francklemoine/Ampli-HiFi/README.md

# HiFi

This repository contains my amplifier and pre-amplifier schematics, program and housing.
