francklemoine/Ampli-HiFi/(list of files, cad)

Other CAD files:
Boitier/ampli.dxf
Boitier/ampli.dwg
