francklemoine/Ampli-HiFi/KiCad/select_board/select_board.kicad_pcb

## KiCad design KiCad/select_board/select_board.kicad_pcb (2017-11-20)

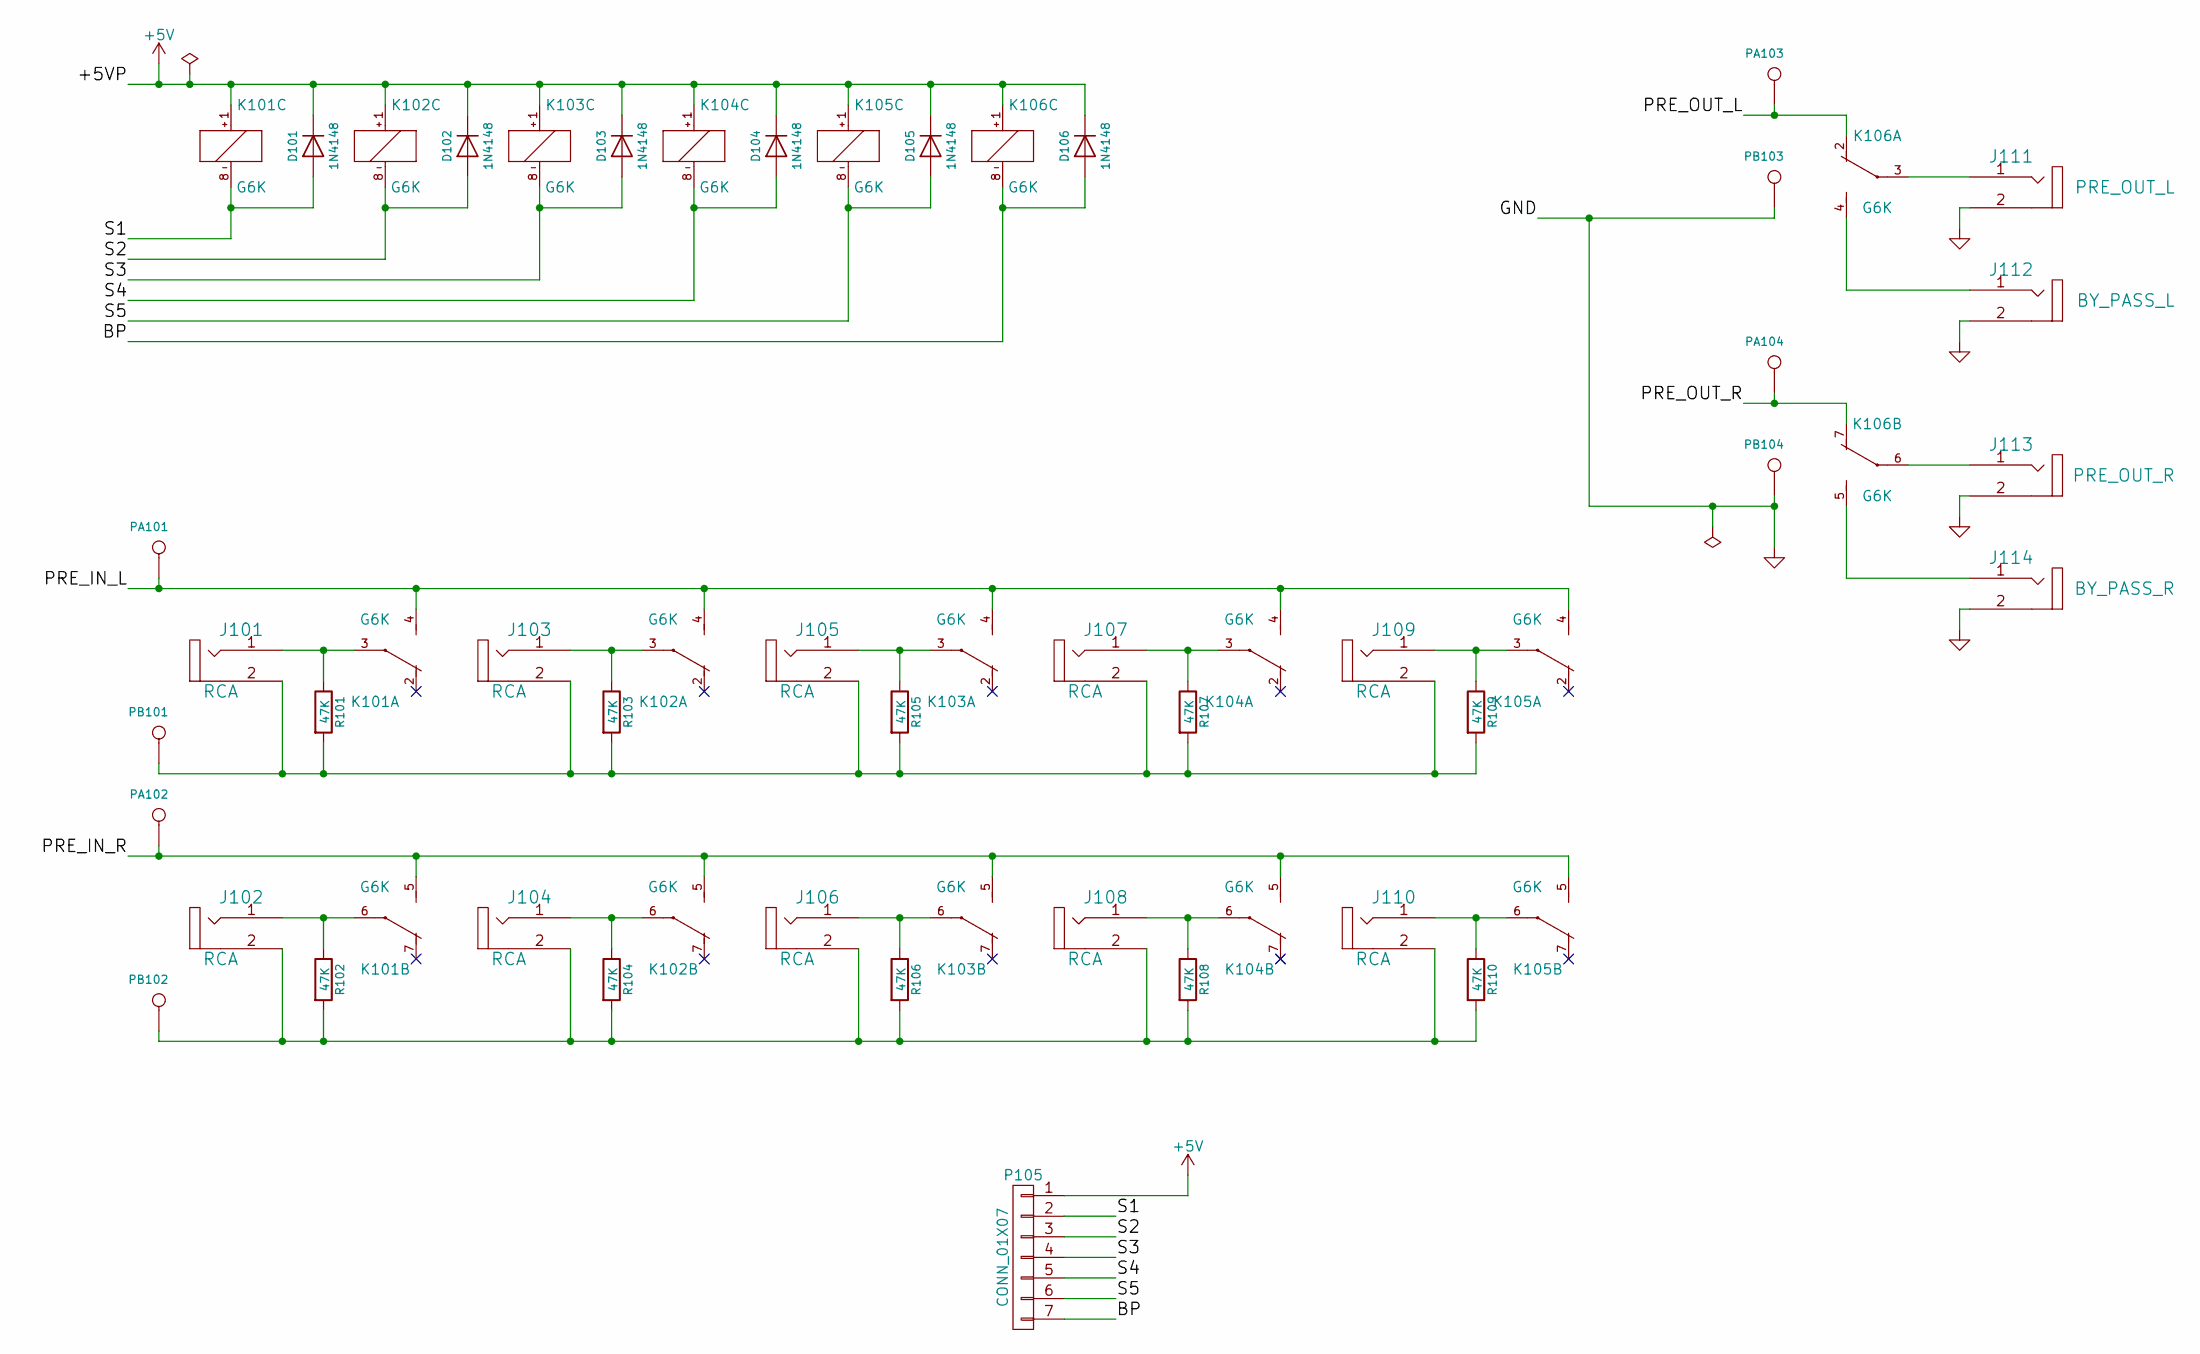
[picture p1: schematic select_board.sch, Préamplificateur / Amplificateur HiFi]

Parts:
D101, D102, D103, D104, D105, D106: 1N4148; D_DO-35_SOD27_P7.62mm_Horizontal
J101, J102, J103, J104, J105, J106, J107, J108, J109, J110: RCA; RCA_ELECAUDIO_ER107
J111: PRE_OUT_L; RCA_ELECAUDIO_ER107
J112: BY_PASS_L; RCA_ELECAUDIO_ER107
J113: PRE_OUT_R; RCA_ELECAUDIO_ER107
J114: BY_PASS_R; RCA_ELECAUDIO_ER107
K101, K102, K103, K104, K105, K106: G6K; Omron-G6K-2F-Y
P105: CONN_01X07; Pin_Header_Straight_1x07_Pitch2.54mm
PA101, PA102, PA103, PA104: CONN_1; 1Pin_d1.8mm_D3.4mm
PB101, PB102, PB103, PB104: CONN_1; 1Pin_d1.8mm_D3.4mm
R101, R102, R103, R104, R105, R106, R107, R108, R109, R110: 47K; R_1206

Connections:
+5V: D101.1 (K), D102.1 (K), D103.1 (K), D104.1 (K), D105.1 (K), D106.1 (K), K101.1 (+), K102.1 (+), K103.1 (+), K104.1 (+), K105.1 (+), K106.1 (+), P105.1
/BP: D106.2 (A), K106.8 (-), P105.7
/PRE_IN_L: K101.4 (S), K102.4 (S), K103.4 (S), K104.4 (S), K105.4 (S), PA101.1
/PRE_IN_R: K101.5 (S), K102.5 (S), K103.5 (S), K104.5 (S), K105.5 (S), PA102.1
/PRE_OUT_L: K106.2 (O), PA103.1
/PRE_OUT_R: K106.7 (O), PA104.1
/S1: D101.2 (A), K101.8 (-), P105.2
/S2: D102.2 (A), K102.8 (-), P105.3
/S3: D103.2 (A), K103.8 (-), P105.4
/S4: D104.2 (A), K104.8 (-), P105.5
/S5: D105.2 (A), K105.8 (-), P105.6
GND: J111.2 (S), J112.2 (S), J113.2 (S), J114.2 (S), PB103.1, PB104.1
unnamed: J101.1 (T), K101.3, R101.1
unnamed: J101.2 (S), J103.2 (S), J105.2 (S), J107.2 (S), J109.2 (S), PB101.1, R101.2, R103.2, R105.2, R107.2, R109.2
unnamed: J102.1 (T), K101.6, R102.1
unnamed: J102.2 (S), J104.2 (S), J106.2 (S), J108.2 (S), J110.2 (S), PB102.1, R102.2, R104.2, R106.2, R108.2, R110.2
unnamed: J103.1 (T), K102.3, R103.1
unnamed: J104.1 (T), K102.6, R104.1
unnamed: J105.1 (T), K103.3, R105.1
unnamed: J106.1 (T), K103.6, R106.1
unnamed: J107.1 (T), K104.3, R107.1
unnamed: J108.1 (T), K104.6, R108.1
unnamed: J109.1 (T), K105.3, R109.1
unnamed: J110.1 (T), K105.6, R110.1
unnamed: J111.1 (T), K106.3
unnamed: J112.1 (T), K106.4 (S)
unnamed: J113.1 (T), K106.6
unnamed: J114.1 (T), K106.5 (S)

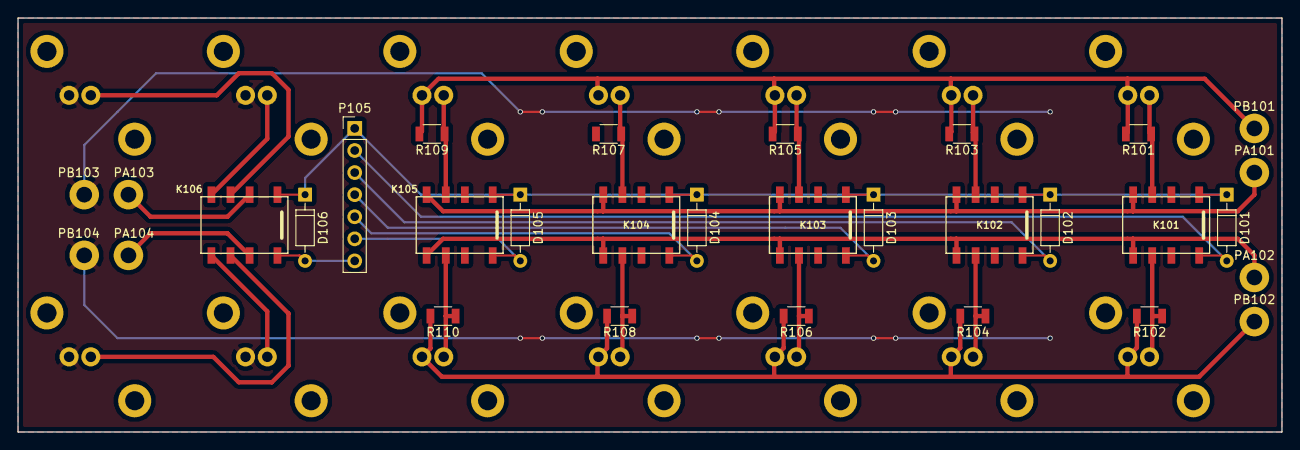
[picture p2: board select_board.kicad_pcb from above]

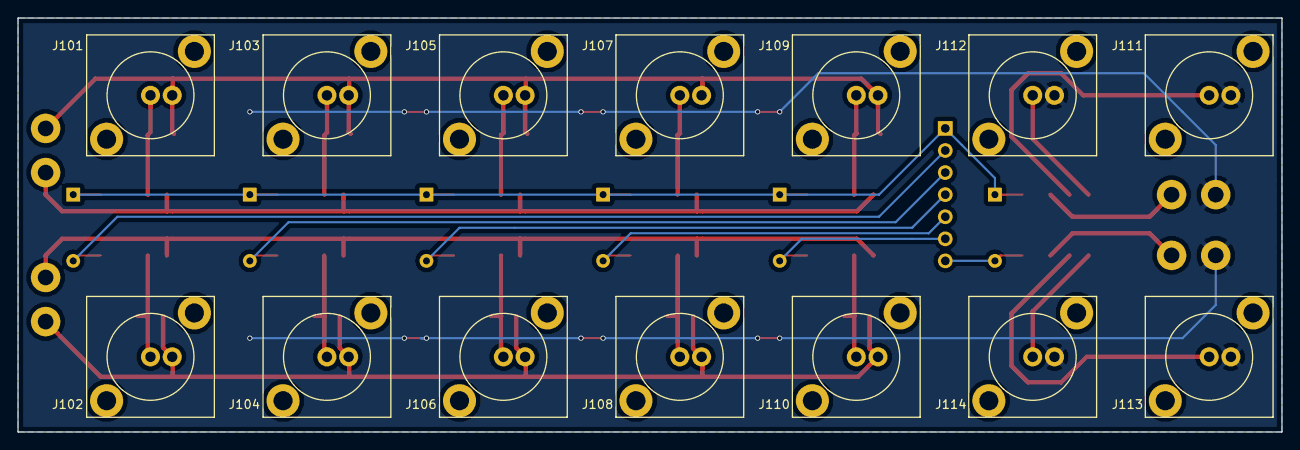
[picture p3: board select_board.kicad_pcb from below]

Board: 2 copper layers, 145.4 x 47.6 mm, 45 parts (14 on the bottom side), 28 nets.
