francklemoine/Ampli-HiFi/KiCad/mcu_board/mcu_board.kicad_pcb

## KiCad design KiCad/mcu_board/mcu_board.kicad_pcb (2017-11-20)

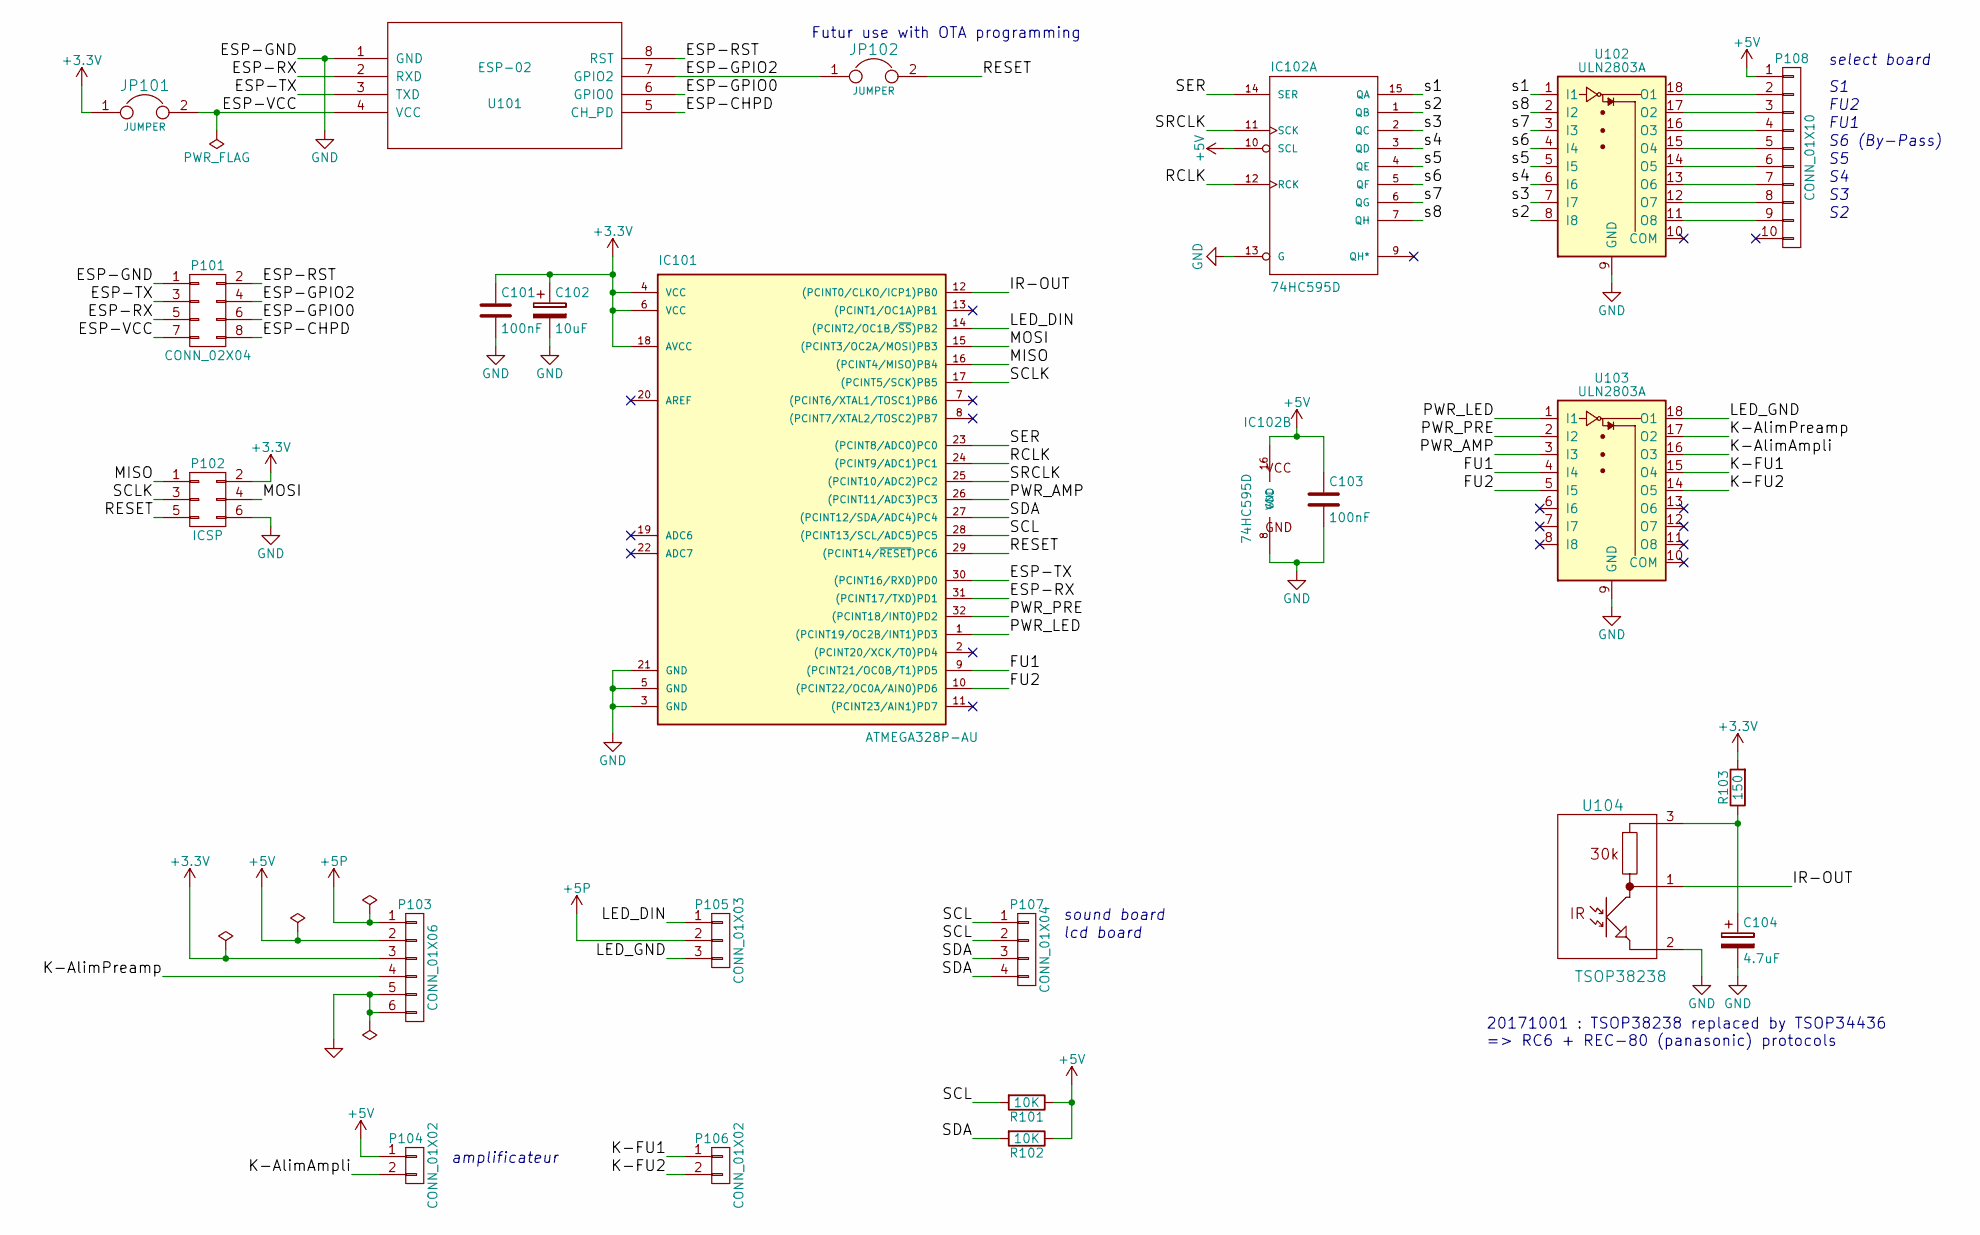
[picture p4: schematic mcu_board.sch, Préamplificateur / Amplificateur HiFi]

Parts:
C101, C103: 100nF; C_0603_HandSoldering
C102: 10uF; CP_Radial_D5.0mm_P2.50mm
C104: 4.7uF; CP_Radial_D5.0mm_P2.50mm
IC101: ATMEGA328P-AU; TQFP-32_7x7mm_Pitch0.8mm
IC102: 74HC595D; SO-16-N
JP101, JP102: JUMPER; Test_Point_2Pads
P101: CONN_02X04; Pin_Header_Straight_2x04_Pitch2.54mm
P102: ICSP; Pin_Header_Straight_2x03_Pitch2.54mm
P103: CONN_01X06; Pin_Header_Straight_1x06_Pitch2.54mm
P104, P106: CONN_01X02; Pin_Header_Straight_1x02_Pitch2.54mm
P105: CONN_01X03; Pin_Header_Straight_1x03_Pitch2.54mm
P107: CONN_01X04; Pin_Header_Straight_1x04_Pitch2.54mm
P108: CONN_01X10; Pin_Header_Straight_1x10_Pitch2.54mm
R101, R102: 10K; R_1206_HandSoldering
R103: 150; R_1206_HandSoldering
U101: ESP-02; ESP8266_ESP_02_SMD_Handsoldering
U102, U103: ULN2803A; SOIC-18W_7.5x11.6mm_Pitch1.27mm
U104: TSOP38238; TSOP382

Connections:
+3V3: C101.1, C102.1, IC101.4 (VCC), IC101.6 (VCC), IC101.18 (AVCC), JP101.1, P102.2, P103.3, R103.2
+5P: P103.1, P105.2
+5V: C103.1, IC102.10 (SCL), IC102.16 (VCC), P103.2, P104.1, P108.1, R101.1, R102.1
/ESP-CHPD: P101.8, U101.5 (CH_PD)
/ESP-GPIO0: P101.6, U101.6 (GPIO0)
/ESP-GPIO2: JP102.1, P101.4, U101.7 (GPIO2)
/ESP-RST: P101.2, U101.8 (RST)
/ESP-RX: IC101.31 ((PCINT17/TXD)PD1), P101.5, U101.2 (RXD)
/ESP-TX: IC101.30 ((PCINT16/RXD)PD0), P101.3, U101.3 (TXD)
/ESP-VCC: JP101.2, P101.7, U101.4 (VCC)
/FU1: IC101.9 ((PCINT21/OC0B/T1)PD5), U103.4 (I4)
/FU2: IC101.10 ((PCINT22/OC0A/AIN0)PD6), U103.5 (I5)
/IR-OUT: IC101.12 ((PCINT0/CLKO/ICP1)PB0), U104.1
/K-AlimAmpli: P104.2, U103.16 (O3)
/K-AlimPreamp: P103.4, U103.17 (O2)
/K-FU1: P106.1, U103.15 (O4)
/K-FU2: P106.2, U103.14 (O5)
/LED_DIN: IC101.14 ((PCINT2/OC1B/~SS~)PB2), P105.1
/LED_GND: P105.3, U103.18 (O1)
/MISO: IC101.16 ((PCINT4/MISO)PB4), P102.1
/MOSI: IC101.15 ((PCINT3/OC2A/MOSI)PB3), P102.4
/PWR_AMP: IC101.26 ((PCINT11/ADC3)PC3), U103.3 (I3)
/PWR_LED: IC101.1 ((PCINT19/OC2B/INT1)PD3), U103.1 (I1)
/PWR_PRE: IC101.32 ((PCINT18/INT0)PD2), U103.2 (I2)
/RCLK: IC101.24 ((PCINT9/ADC1)PC1), IC102.12 (RCK)
/RESET: IC101.29 ((PCINT14/~RESET~)PC6), JP102.2, P102.5
/SCL: IC101.28 ((PCINT13/SCL/ADC5)PC5), P107.1, P107.2, R101.2
/SCLK: IC101.17 ((PCINT5/SCK)PB5), P102.3
/SDA: IC101.27 ((PCINT12/SDA/ADC4)PC4), P107.3, P107.4, R102.2
/SER: IC101.23 ((PCINT8/ADC0)PC0), IC102.14 (SER)
/SRCLK: IC101.25 ((PCINT10/ADC2)PC2), IC102.11 (SCK)
/s1: IC102.15 (QA), U102.1 (I1)
/s2: IC102.1 (QB), U102.8 (I8)
/s3: IC102.2 (QC), U102.7 (I7)
/s4: IC102.3 (QD), U102.6 (I6)
/s5: IC102.4 (QE), U102.5 (I5)
/s6: IC102.5 (QF), U102.4 (I4)
/s7: IC102.6 (QG), U102.3 (I3)
/s8: IC102.7 (QH), U102.2 (I2)
GND: C101.2, C102.2, C103.2, C104.2, IC101.3 (GND), IC101.5 (GND), IC101.21 (GND), IC102.8 (GND), IC102.13 (G), P101.1, P102.6, P103.5, P103.6, U101.1 (GND), U102.9 (GND), U103.9 (GND), U104.2
unnamed: C104.1, R103.1, U104.3
unnamed: P108.2, U102.18 (O1)
unnamed: P108.3, U102.17 (O2)
unnamed: P108.4, U102.16 (O3)
unnamed: P108.5, U102.15 (O4)
unnamed: P108.6, U102.14 (O5)
unnamed: P108.7, U102.13 (O6)
unnamed: P108.8, U102.12 (O7)
unnamed: P108.9, U102.11 (O8)

Notes on the sheet:
select board
amplificateur
sound board
lcd board
S6 (By-Pass)
FU1
FU2
Futur use with OTA programming
20171001 : TSOP38238 replaced by TSOP34436 => RC6 + REC-80 (panasonic) protocols

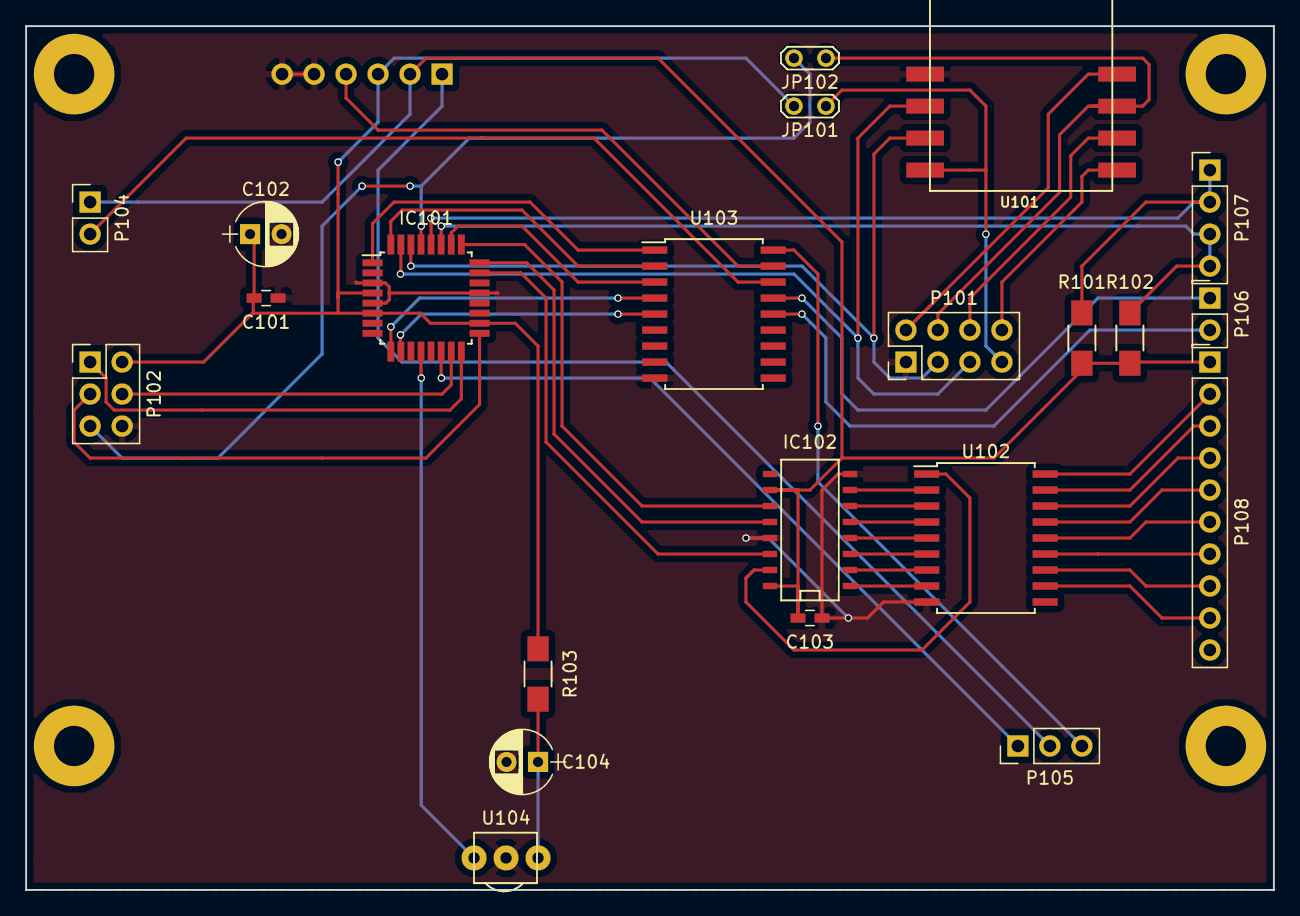
[picture p5: board mcu_board.kicad_pcb from above]

Board: 2 copper layers, 99.1 x 68.6 mm, 23 parts (1 on the bottom side), 49 nets.
