francklemoine/Ampli-HiFi/KiCad/sound_board/sound_board.kicad_pcb

## KiCad design KiCad/sound_board/sound_board.kicad_pcb (2017-07-31)

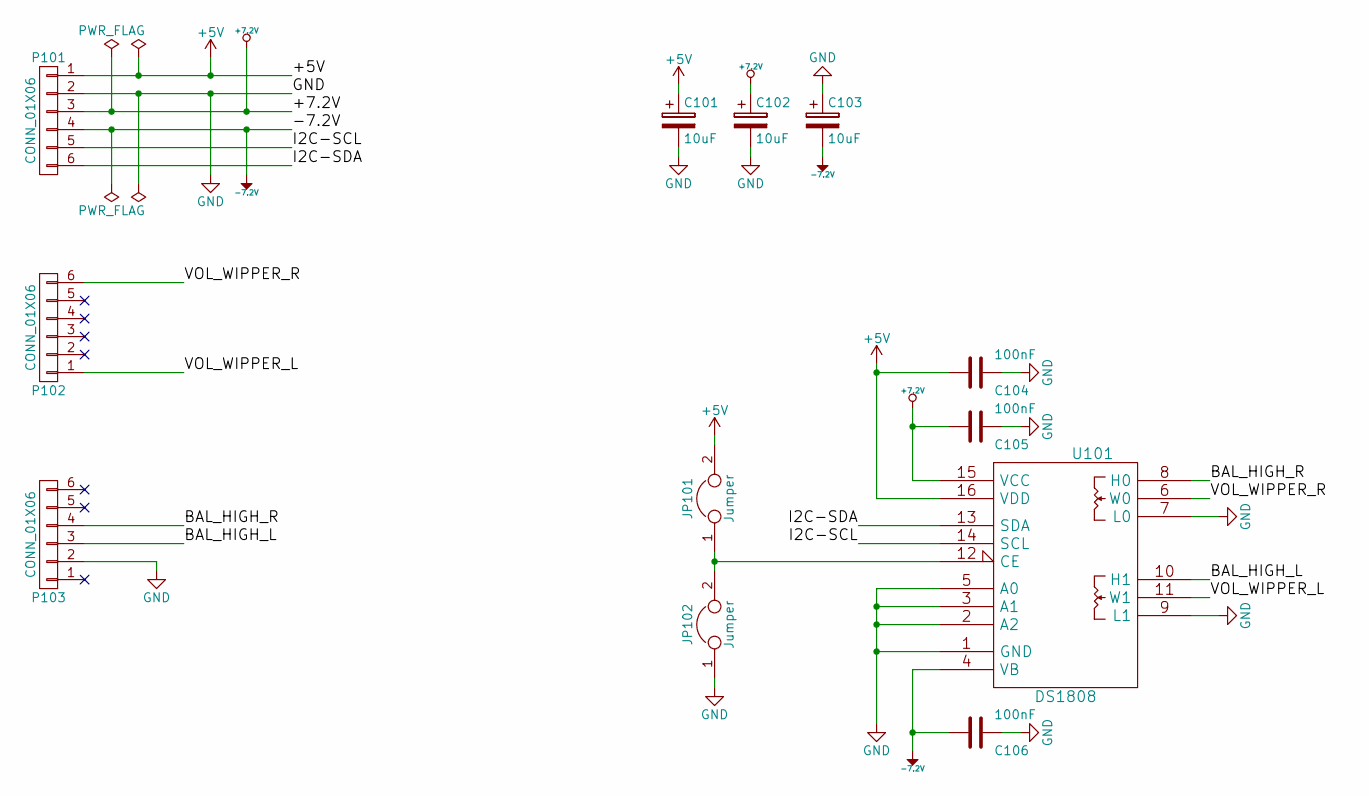
[picture p6: schematic sound_board.sch, Préamplificateur / Amplificateur HiFi]

Parts:
C101, C102, C103: 10uF; CP_Radial_D5.0mm_P2.50mm
C104, C105, C106: 100nF; C_0603_HandSoldering
JP101, JP102: Jumper; Test_Point_2Pads
P101, P102, P103: CONN_01X06; Pin_Header_Straight_1x06_Pitch2.54mm
U101: DS1808; SO-16-N

Connections:
+5V: C101.1, C104.2, JP101.2, P101.1, U101.16 (VDD)
+7.2V: C102.1, C105.2, P101.3, U101.15 (VCC)
-7.2V: C103.2, C106.2, P101.4, U101.4 (VB)
/BAL_HIGH_L: P103.3, U101.10 (H1)
/BAL_HIGH_R: P103.4, U101.8 (H0)
/I2C-SCL: P101.5, U101.14 (SCL)
/I2C-SDA: P101.6, U101.13 (SDA)
/VOL_WIPPER_L: P102.1, U101.11 (W1)
/VOL_WIPPER_R: P102.6, U101.6 (W0)
GND: C101.2, C102.2, C103.1, C104.1, C105.1, C106.1, JP102.1, P101.2, P103.2, U101.1 (GND), U101.2 (A2), U101.3 (A1), U101.5 (A0), U101.7 (L0), U101.9 (L1)
unnamed: JP101.1, JP102.2, U101.12 (CE)

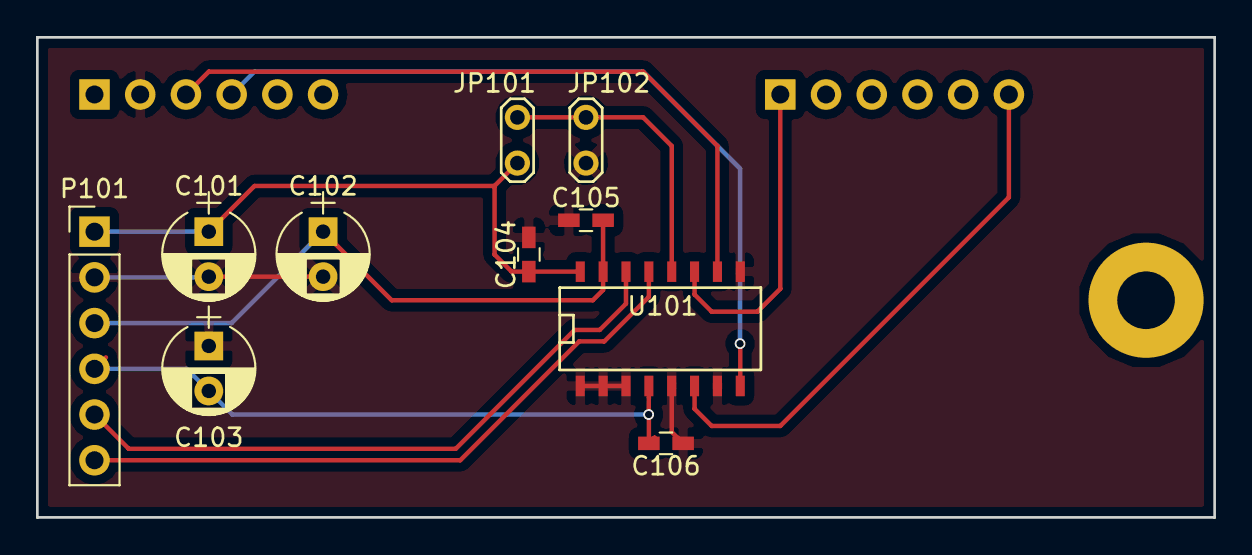
[picture p7: board sound_board.kicad_pcb from above]

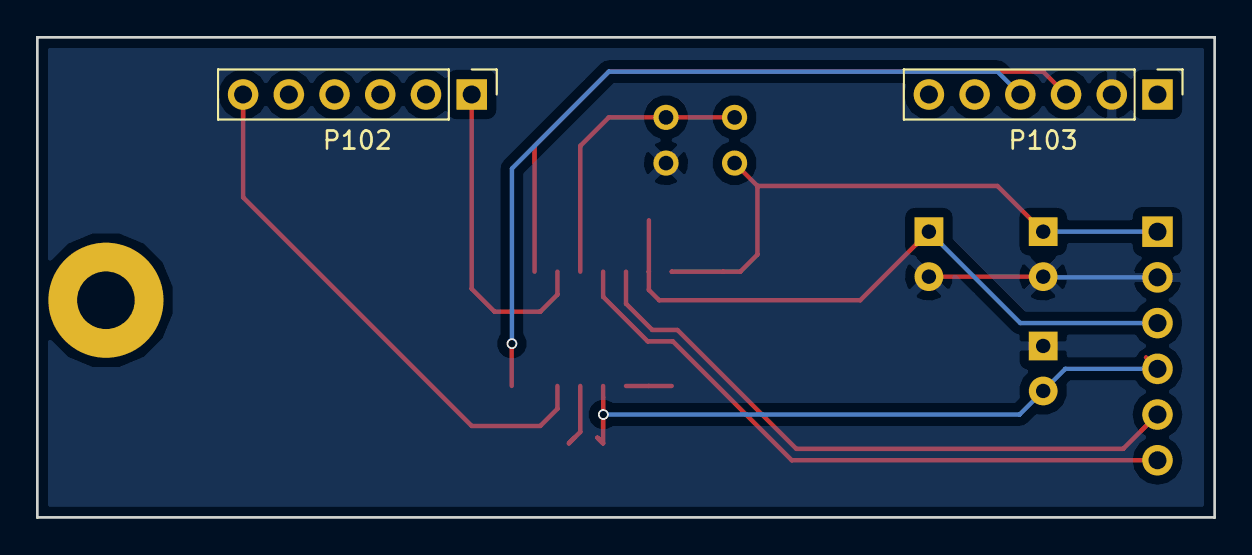
[picture p8: board sound_board.kicad_pcb from below]

Board: 2 copper layers, 65.4 x 26.7 mm, 12 parts (2 on the bottom side), 11 nets.
