francklemoine/Ampli-HiFi/KiCad/power_board/power_board.kicad_pcb

## KiCad design KiCad/power_board/power_board.kicad_pcb (2017-03-10)

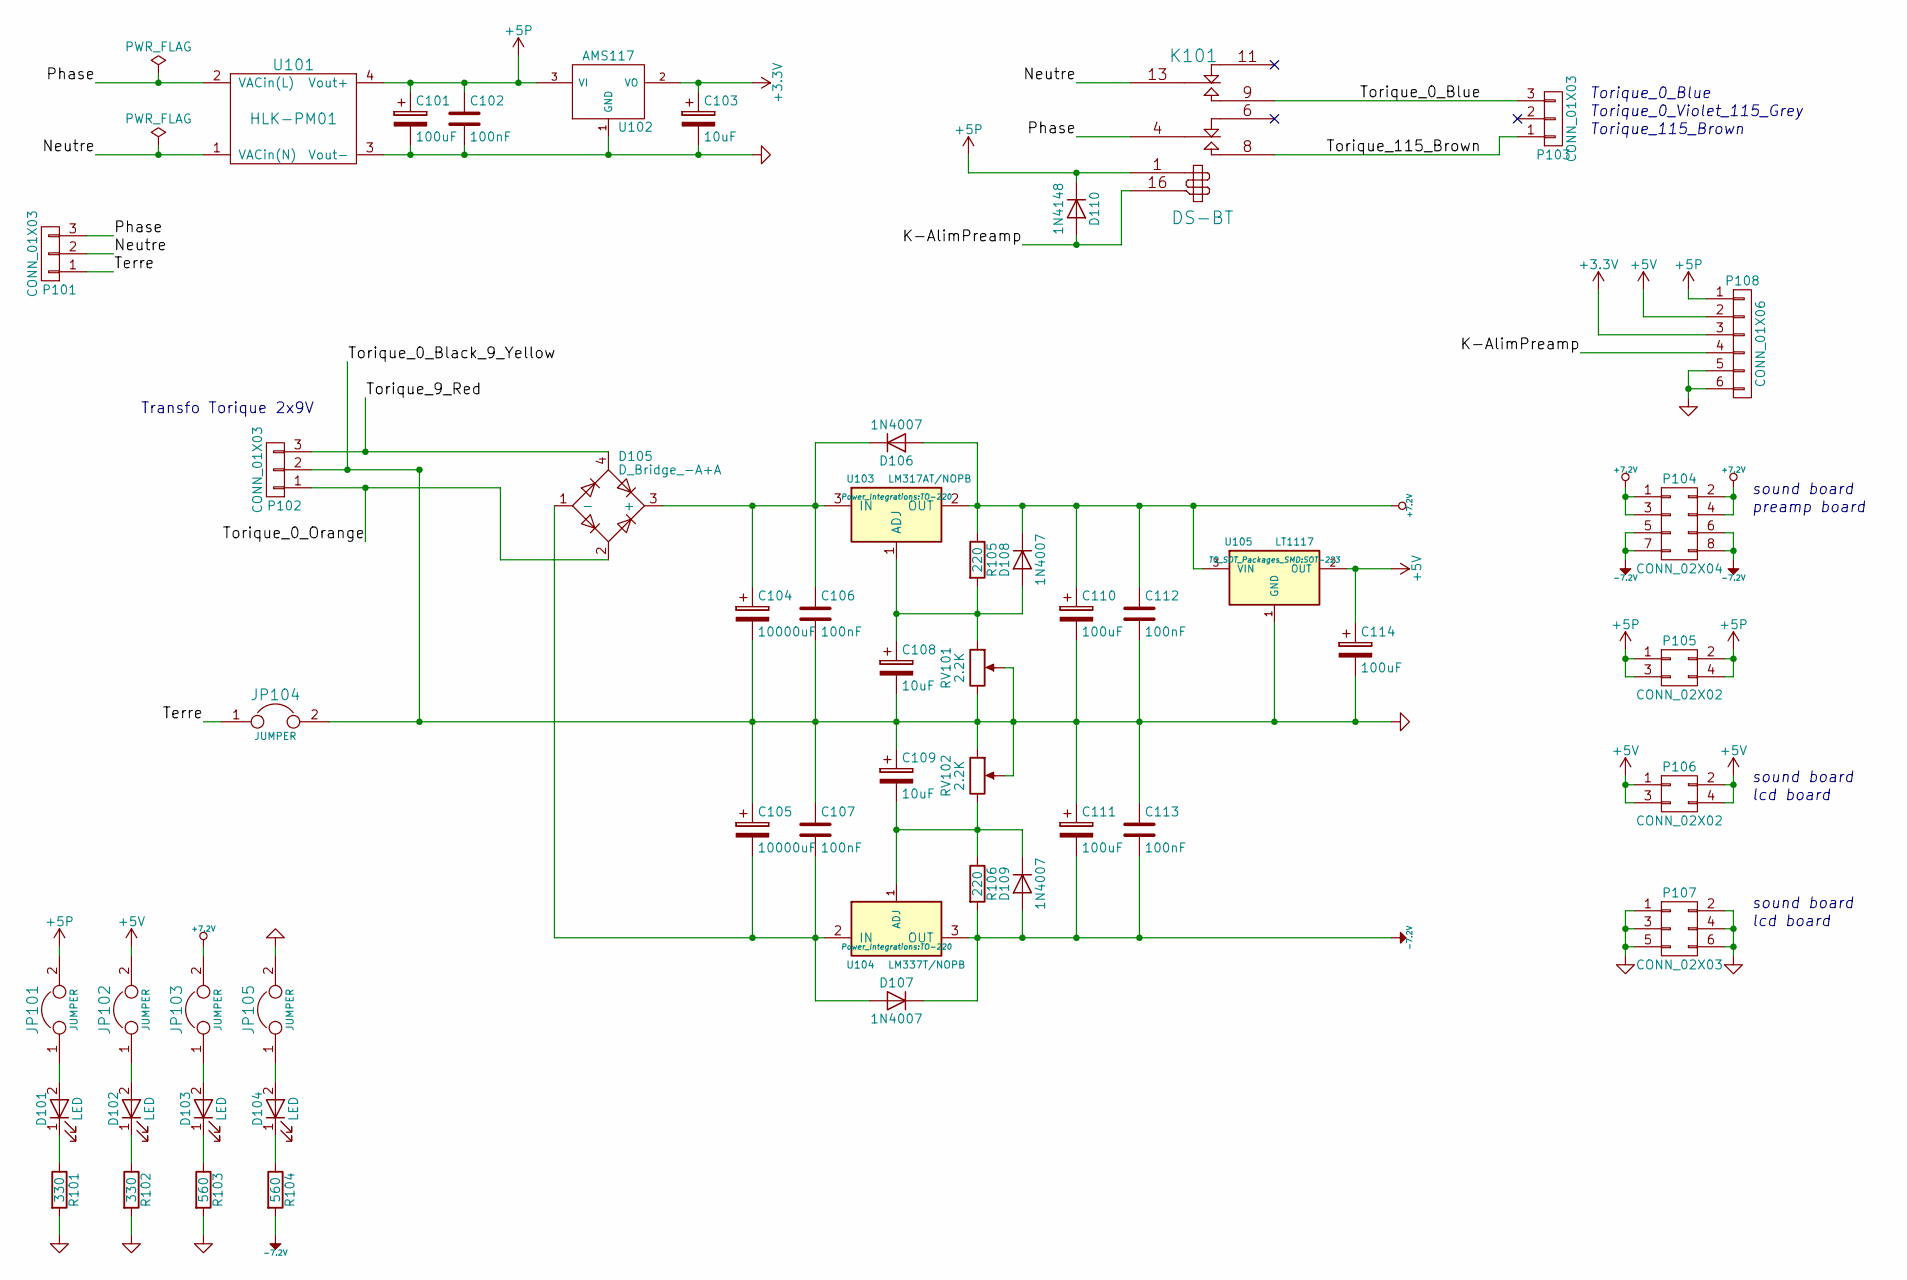
[picture p9: schematic power_board.sch, Préamplificateur / Amplificateur HiFi]

Parts:
C101, C110, C111, C114: 100uF; CP_Radial_D10.0mm_P5.00mm
C102, C106, C107, C112, C113: 100nF; C_0603_HandSoldering
C103, C108, C109: 10uF; CP_Radial_D5.0mm_P2.50mm
C104, C105: 10000uF; CP_Radial_D25.0mm_P10.00mm_SnapIn
D101, D102, D103, D104: LED; LED_1206
D105: D_Bridge_-A+A; Bridge
D106, D107, D108, D109: 1N4007; D_DO-41_SOD81_P10.16mm_Horizontal
D110: 1N4148; D_DO-35_SOD27_P10.16mm_Horizontal
JP101, JP102, JP103, JP104, JP105: JUMPER; Test_Point_2Pads
K101: DS-BT; Relay_DS-BT_Nais
P101, P102, P103: CONN_01X03; CONN_AK350_03_5.08
P104: CONN_02X04; Pin_Header_Straight_2x04_Pitch2.54mm
P105, P106: CONN_02X02; Pin_Header_Straight_2x02_Pitch2.54mm
P107: CONN_02X03; Pin_Header_Straight_2x03_Pitch2.54mm
P108: CONN_01X06; Pin_Header_Straight_1x06_Pitch2.54mm
R101, R102: 330; R_1206_HandSoldering
R103, R104: 560; R_1206_HandSoldering
R105, R106: 220; R_1206_HandSoldering
RV101, RV102: 2.2K; Potentiometer_Bourns_3296W_3-8Zoll_Inline_ScrewUp
U101: HLK-PM01
U102: AMS117; SOT-223
U103: LM317AT/NOPB; TO-220
U104: LM337T/NOPB; TO-220
U105: LT1117; SOT-223

Connections:
+3V3: C103.1, P108.3, U102.2 (VO)
+5P: C101.1, C102.1, D110.1 (K), JP101.2, K101.1 (+), P105.1, P105.2, P105.3, P105.4, P108.1, U101.4 (Vout+), U102.3 (VI)
+5V: C114.1, JP102.2, P106.1, P106.2, P106.3, P106.4, P108.2, U105.2 (OUT)
+7.2V: C110.1, C112.1, D106.2 (A), D108.1 (K), JP103.2, P104.1, P104.2, P104.3, P104.4, R105.1, U103.2 (OUT), U105.3 (VIN)
-7.2V: C111.2, C113.2, D107.1 (K), D109.2 (A), P104.5, P104.6, P104.7, P104.8, R104.2, R106.2, U104.3 (OUT)
/K-AlimPreamp: D110.2 (A), K101.16 (-), P108.4
/Neutre: K101.13 (C2), P101.2, U101.1 (VACin(N))
/Phase: K101.4 (C1), P101.3, U101.2 (VACin(L))
/Terre: JP104.1, P101.1
/Torique_0_Blue: K101.9 (T2), P103.3
/Torique_0_Orange: D105.2, P102.1
/Torique_9_Red: D105.4, P102.3
/Torique_115_Brown: K101.8 (T1), P103.1
GND: C101.2, C102.2, C103.2, C104.2, C105.1, C106.2, C107.1, C108.2, C109.1, C110.2, C111.1, C112.2, C113.1, C114.2, JP104.2, JP105.2, P102.2, P107.1, P107.2, P107.3, P107.4, P107.5, P107.6, P108.5, P108.6, R101.2, R102.2, R103.2, RV101.2, RV101.3, RV102.1, RV102.2, U101.3 (Vout-), U102.1 (GND), U105.1 (GND)
unnamed: C104.1, C106.1, D105.3 (+), D106.1 (K), U103.3 (IN)
unnamed: C105.2, C107.2, D105.1 (-), D107.2 (A), U104.2 (IN)
unnamed: C108.1, D108.2 (A), R105.2, RV101.1, U103.1 (ADJ)
unnamed: C109.2, D109.1 (K), R106.1, RV102.3, U104.1 (ADJ)
unnamed: D101.1 (K), R101.1
unnamed: D101.2 (A), JP101.1
unnamed: D102.1 (K), R102.1
unnamed: D102.2 (A), JP102.1
unnamed: D103.1 (K), R103.1
unnamed: D103.2 (A), JP103.1
unnamed: D104.1 (K), R104.1
unnamed: D104.2 (A), JP105.1

Notes on the sheet:
Transfo Torique 2x9V
sound board
lcd board
preamp board
Torique_0_Blue
Torique_0_Violet_115_Grey
Torique_115_Brown

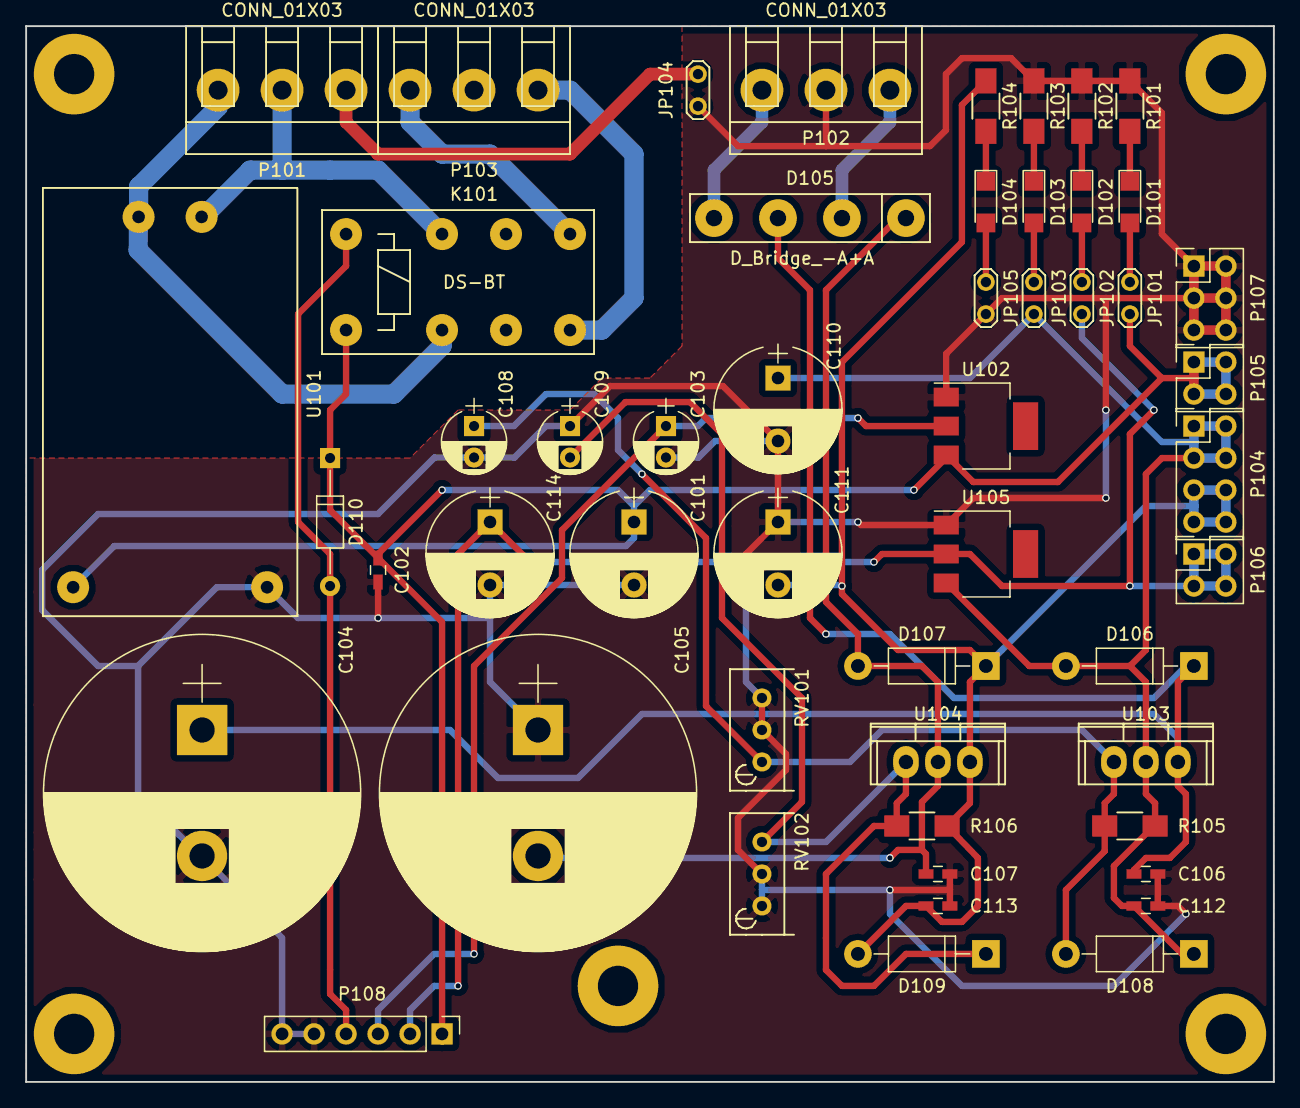
[picture p10: board power_board.kicad_pcb from above]

Board: 2 copper layers, 99.1 x 83.8 mm, 51 parts (0 on the bottom side), 26 nets.
