francklemoine/Ampli-HiFi/KiCad/onoff_ampli_board/onoff_ampli_board.kicad_pcb

## KiCad design KiCad/onoff_ampli_board/onoff_ampli_board.kicad_pcb (2017-02-14)

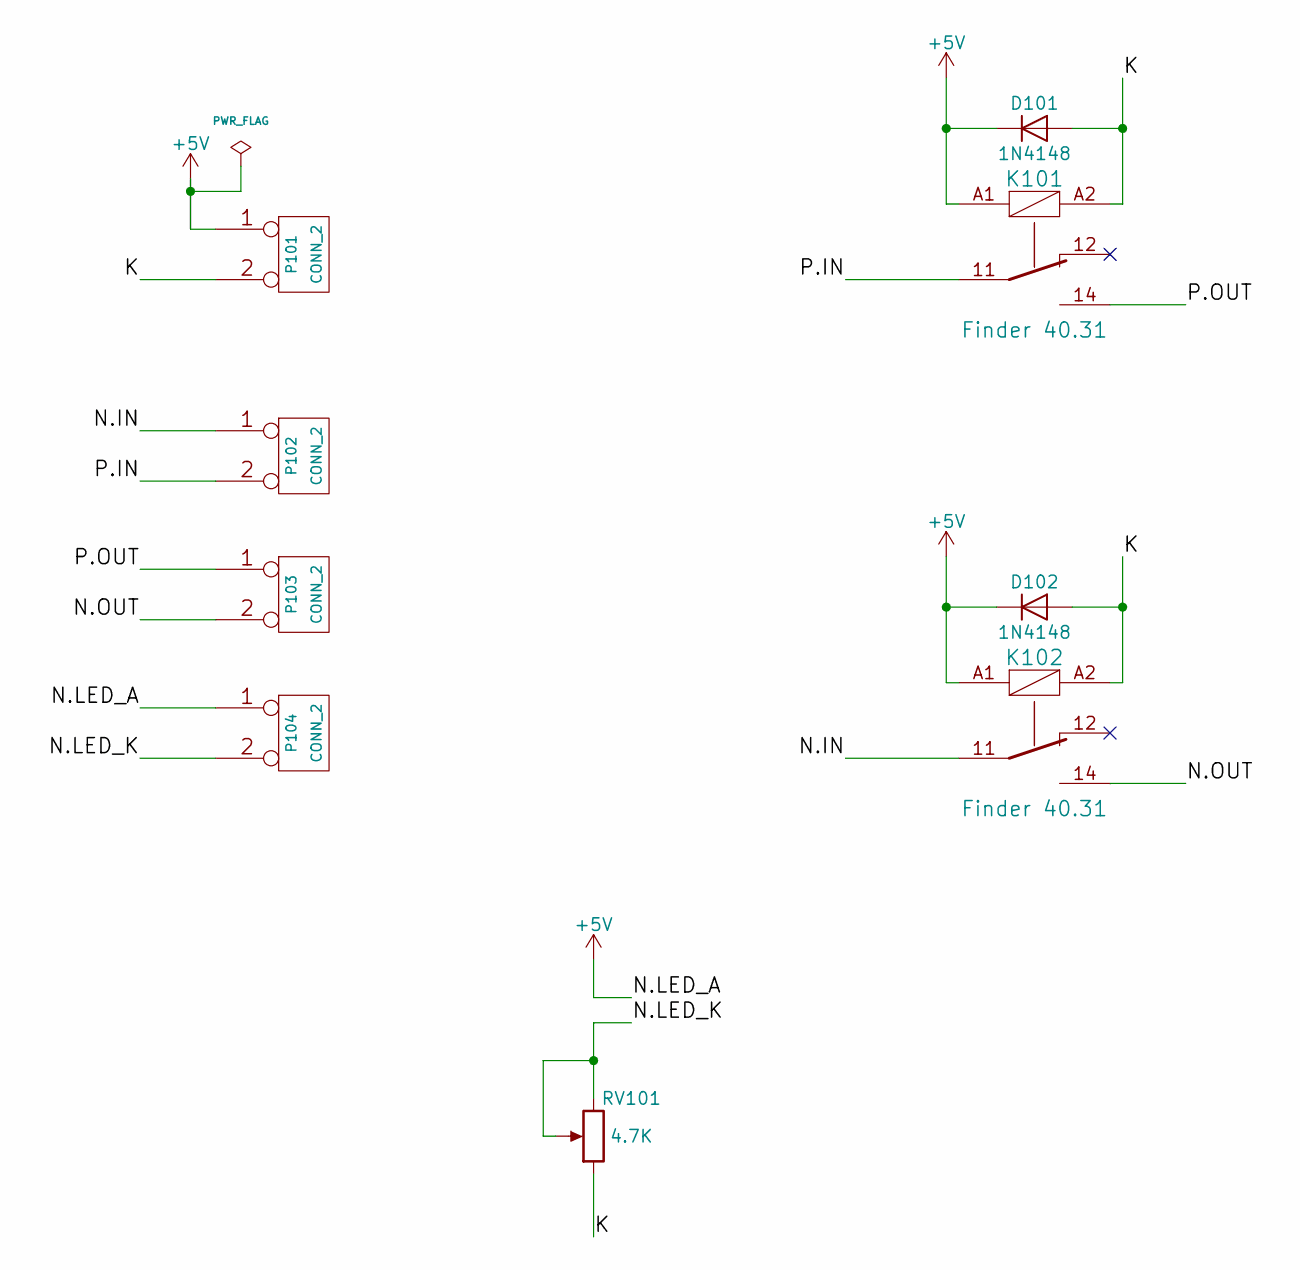
[picture p11: schematic onoff_ampli_board.sch, Préamplificateur / Amplificateur HiFi]

Parts:
D101, D102: 1N4148; D_DO-35_SOD27_P10.16mm_Horizontal
K101, K102: Finder 40.31; Relay_40.31_Finder
P101, P104: CONN_2; Pin_Header_Straight_1x02_Pitch2.54mm
P102, P103: CONN_2; CONN_AK350_02_7.62
RV101: 4.7K; Potentiometer_Bourns_3296W_3-8Zoll_Inline_ScrewUp

Connections:
+5V: D101.1 (K), D102.1 (K), K101.A1, K102.A1, P101.1, P104.1
/K: D101.2 (A), D102.2 (A), K101.A2, K102.A2, P101.2 (PM), RV101.1
/N.IN: K102.11, P102.1
/N.LED_K: P104.2 (PM), RV101.2, RV101.3
/N.OUT: K102.14, P103.2 (PM)
/P.IN: K101.11, P102.2 (PM)
/P.OUT: K101.14, P103.1
