francklemoine/Ampli-HiFi/KiCad/onoff_ampli_board/onoff_ampli_board.kicad_pcb

## KiCad design KiCad/onoff_ampli_board/onoff_ampli_board.kicad_pcb (continued)

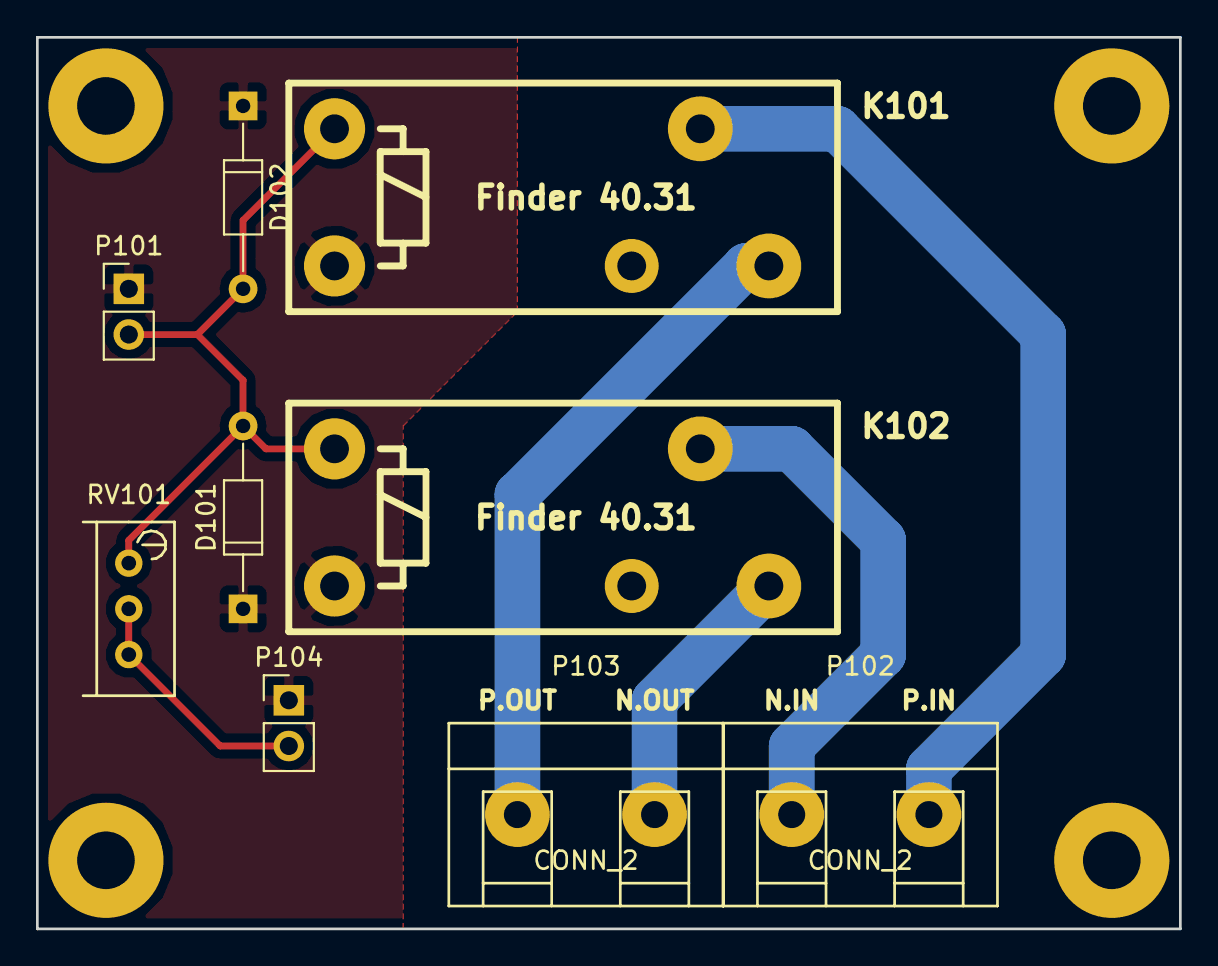
[picture p12: board onoff_ampli_board.kicad_pcb from above]

Board: 2 copper layers, 63.5 x 49.5 mm, 9 parts (0 on the bottom side), 7 nets.
