francklemoine/Ampli-HiFi/(commit log)

2017-02-04 Reorg project tree
    [ampli_hifi.kicad_pcb, ampli_hifi.sch, file587A6E29.sch, file587ABF07.sch, file587B47EC.sch, file587EB2E9.sch, file58818B36.sch, file588FD2C2.sch]
2017-02-07 Correctifs divers
    [mcu_board.kicad_pcb, mcu_board.sch, onoff_ampli_board.kicad_pcb, onoff_ampli_board.sch, power_board.kicad_pcb, power_board.sch, sound_board.kicad_pcb]
2017-02-24 Add connection board (preampli. to ampli.)
    [connect_preampli2ampli_board-B.Cu.gbl, connect_preampli2ampli_board-B.Mask.gbs, connect_preampli2ampli_board-B.SilkS.gbo, connect_preampli2ampli_board-Edge.Cuts.gm1, connect_preampli2ampli_board-F.Cu.gtl, connect_preampli2ampli_board-F.Mask.gts, connect_preampli2ampli_board-F.SilkS.gto, connect_preampli2ampli_board.drl]
2017-07-27 Arduino/Atmega Software - Initial commit
2017-07-31 Only one i2c potentiometer to manage sound
    [sound_board-B.Cu.gbl, sound_board-B.Mask.gbs, sound_board-B.SilkS.gbo, sound_board-Edge.Cuts.gm1, sound_board-F.Cu.gtl, sound_board-F.Mask.gts, sound_board-F.SilkS.gto, sound_board.drl]
2017-10-20 PCB select_board
    [select_board.sch]
2017-10-20 PCB mcu_board: RC5 + REC-80 (panasonic) IR protocols
    [mcu_board.sch]
2017-10-20 Add Gerber files
    [select_board-B.Cu.gbl, select_board-B.Mask.gbs, select_board-B.SilkS.gbo, select_board-Edge.Cuts.gm1, select_board-F.Cu.gtl, select_board-F.Mask.gts, select_board-F.SilkS.gto, select_board.drl]
